CapnKernel/hbridge-breakout/hbridge-breakout.kicad_pcb

## KiCad design hbridge-breakout.kicad_pcb (2024-04-18)

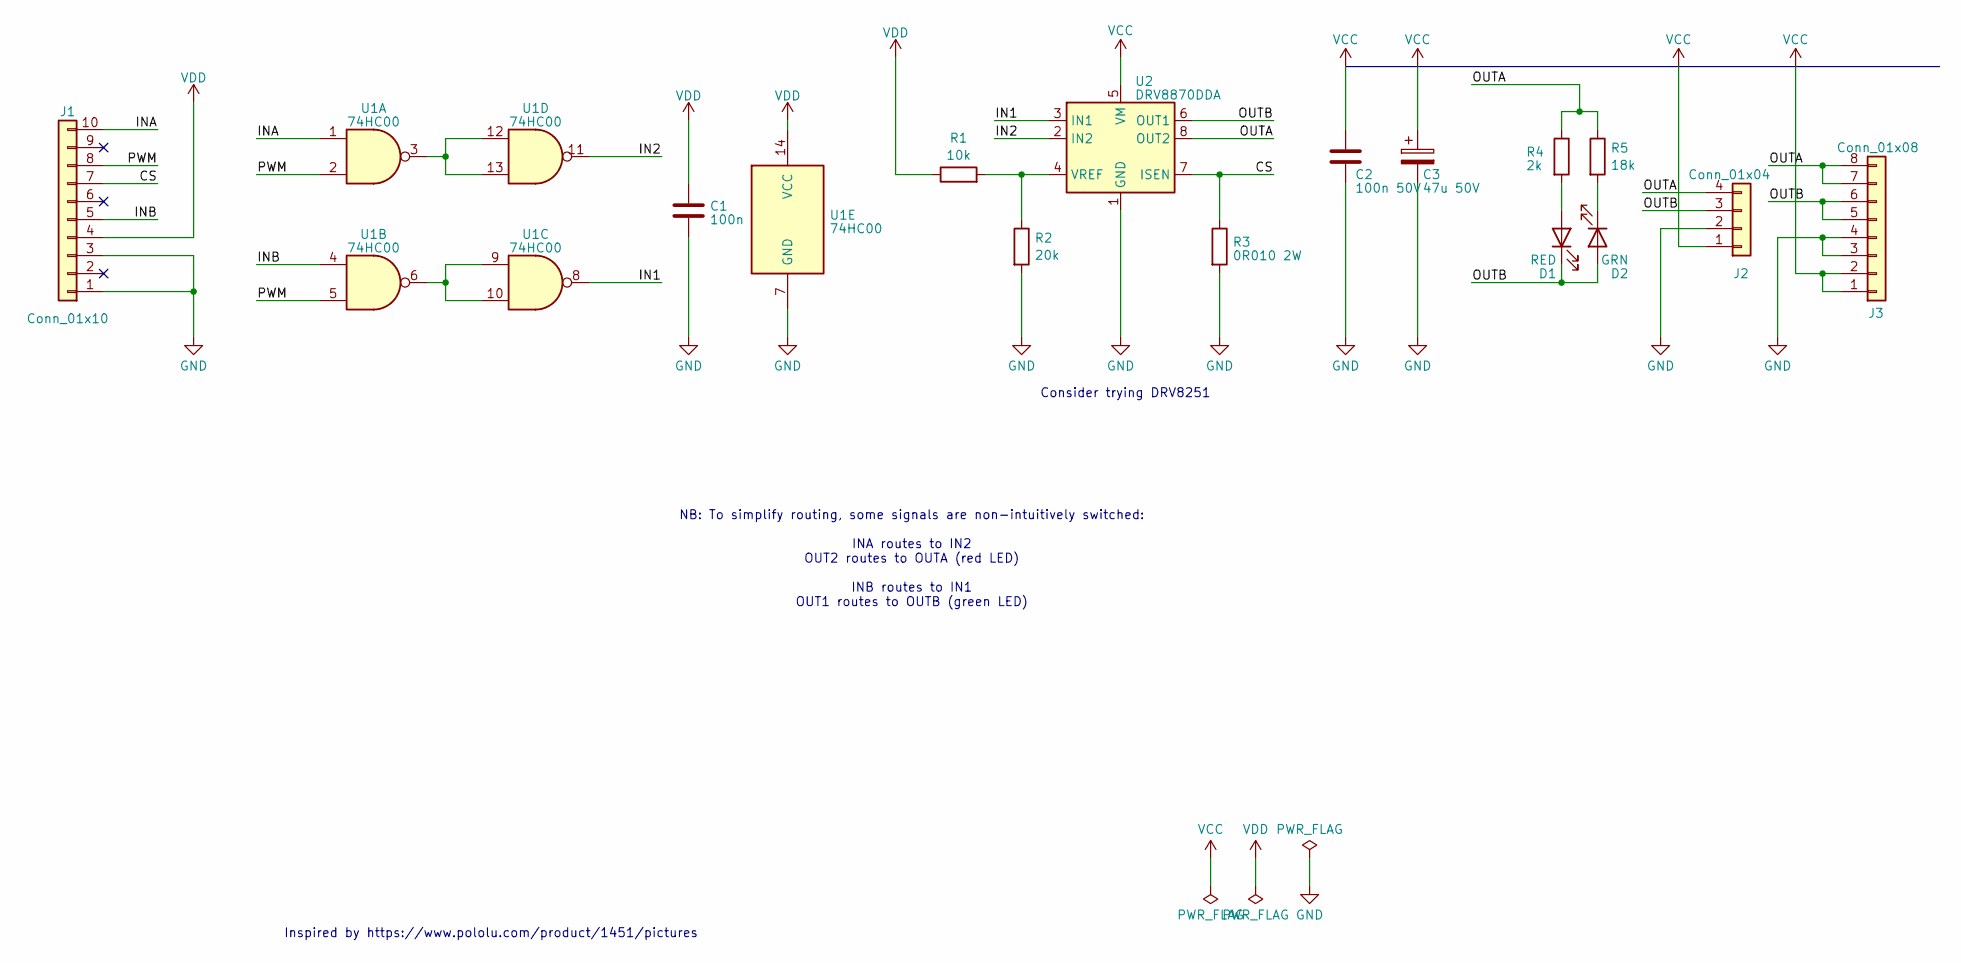
[picture p1: schematic hbridge-breakout.kicad_sch]

Parts:
C1: 100n; C_0805_2012Metric_Pad1.18x1.45mm_HandSolder
C2: 100n 50V; C_0805_2012Metric_Pad1.18x1.45mm_HandSolder
C3: 47u 50V; CP_Radial_D6.3mm_P2.50mm
D1: RED; LED_0805_2012Metric_Pad1.15x1.40mm_HandSolder
D2: GRN; LED_0805_2012Metric_Pad1.15x1.40mm_HandSolder
J1: Conn_01x10; PinHeader_1x10_P2.54mm_Vertical
J2: Conn_01x04; PinHeader_1x04_P5.04mm_Vertical
J3: Conn_01x08; PinHeader_1x08_P2.54mm_Vertical
R1: 10k; R_0805_2012Metric_Pad1.20x1.40mm_HandSolder
R2: 20k; R_0805_2012Metric_Pad1.20x1.40mm_HandSolder
R3: 0R010 2W; R_2512_6332Metric_Pad1.40x3.35mm_HandSolder
R4: 2k; R_0805_2012Metric_Pad1.20x1.40mm_HandSolder
R5: 18k; R_0805_2012Metric_Pad1.20x1.40mm_HandSolder
U1: 74HC00; DIP-14_W7.62mm_LongPads
U2: DRV8870DDA; Texas_HTSOP-8-1EP_3.9x4.9mm_P1.27mm_EP2.95x4.9mm_Mask2.4x3.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

Connections:
/CS: J1.7, R3.1, U2.7 (ISEN)
/IN1: U1.8, U2.3 (IN1)
/IN2: U1.11, U2.2 (IN2)
/INA: J1.10, U1.1
/INB: J1.5, U1.4
/OUTA: J2.4, J3.7, J3.8, R4.1, R5.1, U2.8 (OUT2)
/OUTB: D1.1 (K), D2.2 (A), J2.3, J3.5, J3.6, U2.6 (OUT1)
/PWM: J1.8, U1.2, U1.5
GND: C1.2, C2.2, C3.2, J1.1, J1.3, J2.2, J3.3, J3.4, R2.2, R3.2, U1.7 (GND), U2.1 (GND), U2.9 (GND)
unnamed: D1.2 (A), R4.2
unnamed: D2.1 (K), R5.2
unnamed: U1.6, U1.9, U1.10
unnamed: U1.3, U1.12, U1.13
unnamed: R1.2, R2.1, U2.4 (VREF)
VCC: C2.1, C3.1, J2.1, J3.1, J3.2, U2.5 (VM)
VDD: C1.1, J1.4, R1.1, U1.14 (VCC)

Notes on the sheet:
NB: To simplify routing, some signals are non-intuitively switched: INA routes to IN2 OUT2 routes to OUTA (red LED) INB routes to IN1 OUT1 routes to OUTB (green LED)
Consider trying DRV8251
Inspired by https://www.pololu.com/product/1451/pictures

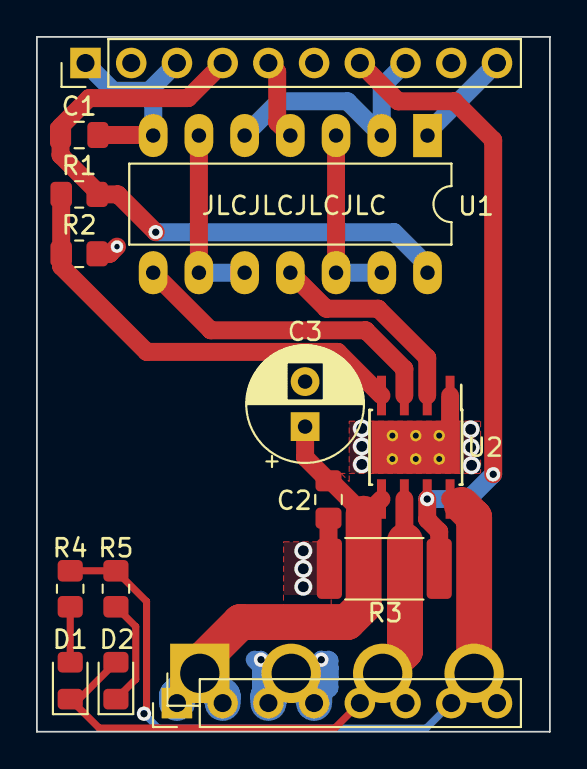
[picture p2: board hbridge-breakout.kicad_pcb from above]

Board: 2 copper layers, 28.5 x 38.6 mm, 15 parts (0 on the bottom side), 16 nets.
