CapnKernel/hbridge-breakout/(commit log)

2023-05-10 Added JLCJLCJLCJLC
    [hbridge-breakout.kicad_pcb]
2023-05-23 Moved current sense via away from chip pin pad, thickened trace.
    [hbridge-breakout.kicad_pcb]
2023-08-16 Hide 3d models of power/motor headers
    [hbridge-breakout.kicad_pcb]
2023-08-16 Improved CS trace to not cut the ground plane so much.
    [hbridge-breakout.kicad_pcb]
2023-08-16 Each direction LED now has its own dropper resistor.
    [hbridge-breakout.kicad_pcb, hbridge-breakout.kicad_sch]
2023-08-16 Added labels to pins
    [hbridge-breakout.kicad_pcb]
2023-09-19 Add note to try DRV8251
    [hbridge-breakout.kicad_sch]
2023-09-19 Heap of rework to make power tracks simpler, and caps closer to chip.
    [hbridge-breakout.kicad_pcb]
2024-04-18 Update for KiCad 8
    [hbridge-breakout.kicad_pcb, hbridge-breakout.kicad_sch]
2024-04-18 Fixed a terrible bug where the power input/outputs at the bottom of the board were flipped.
    [hbridge-breakout.kicad_pcb, hbridge-breakout.kicad_sch]
